Myxir294/Memory_check/README.md

# Memory_check

Repozytorium zawiera program obsługujący układ elektroniczny zaprojektowany w ramach kursu "Elektronika w automatyce". Celem urządzenia było sprawdzanie pamięci krótkotwałej użytkownika poprzez wyświetlanie sekwencji sygnałów świetlnych, które korzystający z urządzenia musiał powtórzyć. Sczegółową dokumentację projektu przedstawiono w załączonym pliku pdf. Dodatkowo zamieszczono program pomocniczy, wykorzystywany w celu ustalenia przypisanych adresów układów scalonych.  

Projekt wykonywany był w grupie dwuosobowej.

Nagrania przedstawiające przykładowy poprawny cykl pracy układu można znaleźć pod
wskazanymi adresami (zalecane jest ustawienie wysokiej jakości obrazu z powodu uszkodzonego podświetlenia)  
a) Poprawne podanie kombinacji  
https://drive.google.com/file/d/1zJMMjE-wq6GwCaH94NiUB0uY9xJXNgDs/view?usp=sharing  
b) Niepoprawne podanie kombinacji  
https://drive.google.com/file/d/1mRVWrHHAmeexanw8YAMwXjTHNmtYrwhV/view?usp=sharing
